jcornell616/Theremax/References/design.jpg

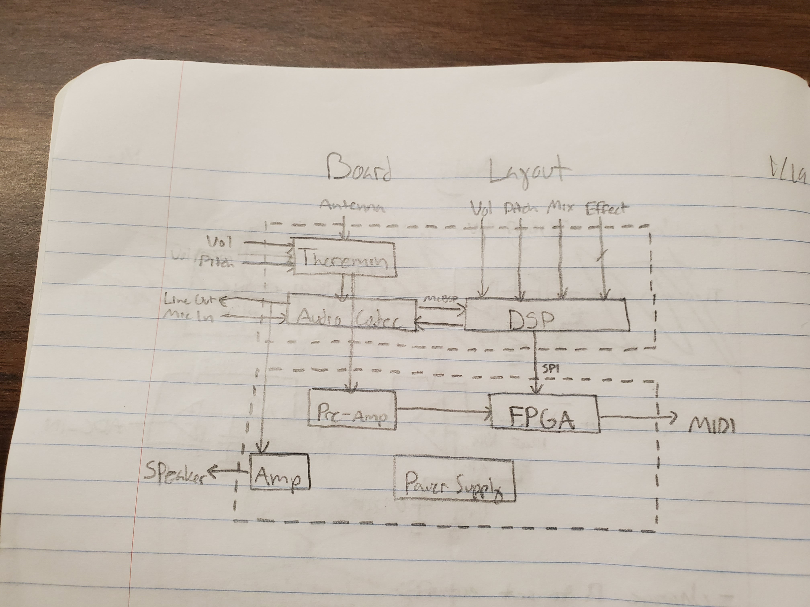
References/design.jpg
