jcornell616/Theremax/Documents/EnclosureDraft.jpg

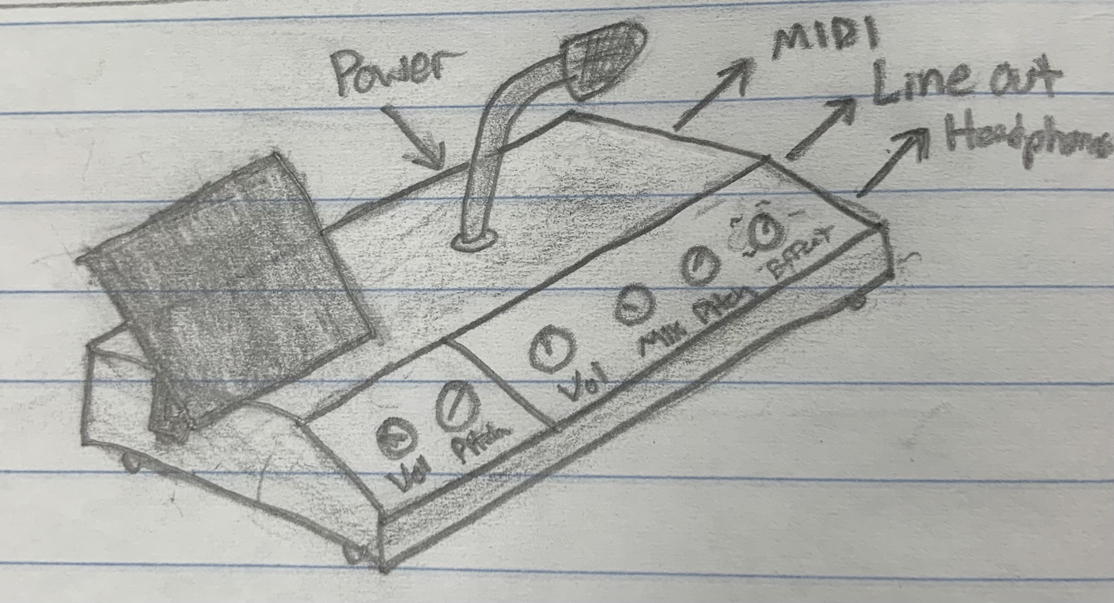
Documents/EnclosureDraft.jpg
