jcornell616/Theremax/Documents/ProgressReports/PR_Cornell_030252022.docx

# Progress Report – 3/25/2022

Jackson Cornell and Eric Barkuloo

- PCBs assembled and debugged
- FPGA pitch detection tweaked
- DSP vocoder code progress continuing

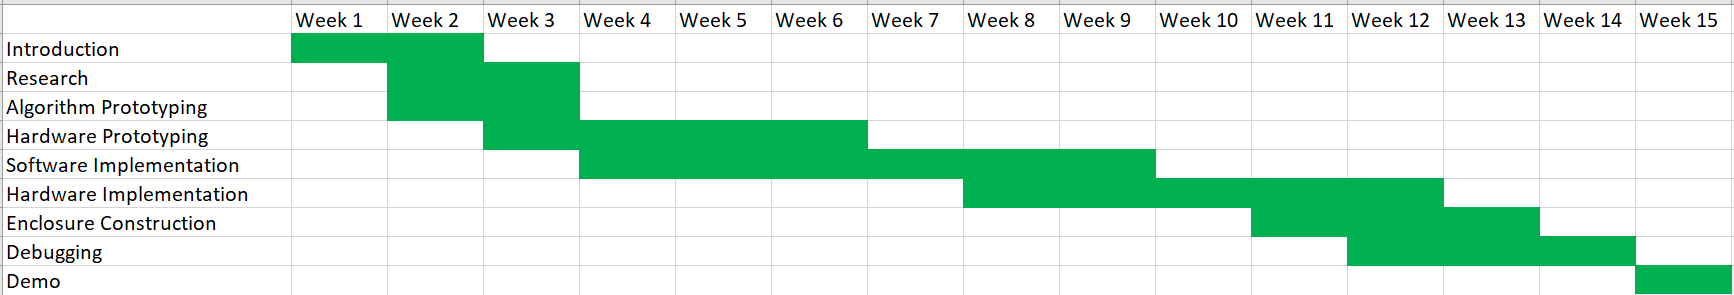
[picture p5: figure]
