jcornell616/Theremax/Documents/ProgressReports/PR_03032022.pdf

# Theremania – PR 3/4/2022

Jackson Cornell – Eric Barkuloo

## Both

- PCB layout finished
- PCBs ordered
- Remaining parts ordered
- Established communication between FPGA and DSP via SPI
