jcornell616/Theremax/Documents/Hardware Block Diagram.jpeg

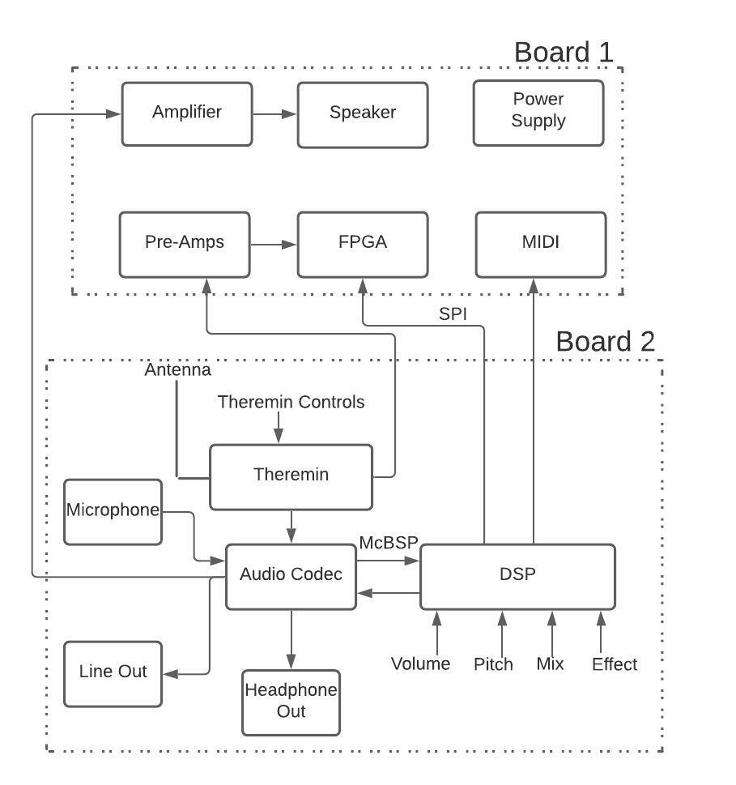
Documents/Hardware Block Diagram.jpeg
