jcornell616/Theremax/Documents/Theremax Software Diagram.jpeg

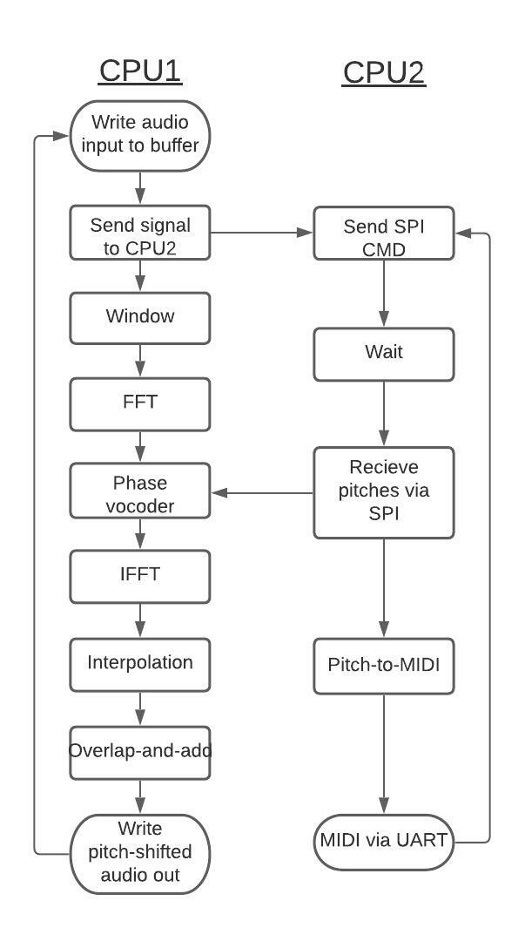
Documents/Theremax Software Diagram.jpeg
