jcornell616/Theremax/References/theramin_schematic4.gif

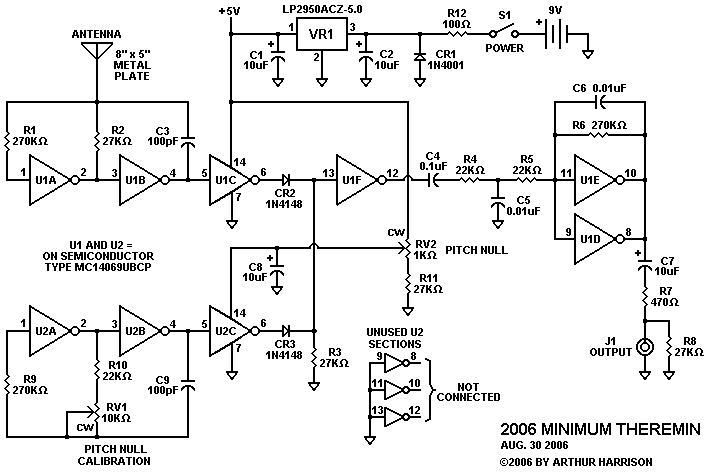
References/theramin_schematic4.gif
