jcornell616/Theremax/Documents/PCB1_Parts.xlsx

Country of Origin may be different at time of shipment.
The HTSUS and ECCN information shown is for informational purposes only and is not a representation or warranty as to the accuracy or reliability of these classifications. All information is provided "as is" and is subject to change without notice. Any use made of the information provided is without recourse to Digi-Key and at the user's risk.
Index | Manufacturer Part Number | Manufacturer Name | Description | Availability | Stock Status | Attrition % | Requested Quantity 1 | Pack Quantity 1 | Pack Type 1 | Digi-Key Part Number 1 | Unit Price 1 | Extended Price 1 | Minimum Order Quantity 1 | Customer Reference | Requested Part Number | Lead Weeks | Datasheet | Reference Designator | US Import Tariff | Note | Part Status | RoHS Status | ECCN | HTSUS | Country of Origin | Environmental Information | Original Part numbers | Image
1 | PAC18R1-41D19F | Bourns Inc. | ENCODER | 165 | In Stock |  | 1 | 1 | Tray | 118-PAC18R1-41D19F-ND | 3.34000 | $3.34 | 1 |  | PAC18R1-41D19F | 24 | //media.digikey.com/pdf/Data%20Sheets/Bourns%20PDFs/PAC18R_Series_DS.pdf |  | May apply on shipments to the U.S. |  | Active | ROHS3 Compliant | EAR99 | 8543.70.4500 | China | https://www.bourns.com/docs/rohs-cofc/coc_en1.pdf?sfvrsn=9f3858d2_12|https://www.bourns.com/docs/rohs-content/bourns-reach-letter.pdf | PAC18R1-41D19F | //media.digikey.com/Photos/Bourns Photos/PAC18R1-41D19F.jpg
2 | PDB181-K420K-103A2 | Bourns Inc. | POT 10K OHM 1/10W CARBON LOG | 162 | In Stock |  | 5 | 5 | Bulk | PDB181-K420K-103A2-ND | 1.24000 | $6.20 | 1 |  | PDB181-K420K-103A2 | 24 | https://www.bourns.com/docs/Product-Datasheets/PDB18.pdf |  | May apply on shipments to the U.S. |  | Active | ROHS3 Compliant | EAR99 | 8533.40.8070 | China | https://www.bourns.com/docs/rohs-content/bourns-reach-letter.pdf |https://www.bourns.com/docs/rohs-cofc/pc1_coc.pdf?sfvrsn=cf7e2294_6 | PDB181-K420K-103A2 | //media.digikey.com/Photos/Bourns%20Photos/PDB181.JPG
3 | P160KN2-0QA25B10K | TT Electronics/BI | POT 10K OHM 1/5W PLASTIC LINEAR | 3,419 | In Stock |  | 5 | 5 | Tray | 987-1715-ND | 0.86000 | $4.30 | 1 |  | P160KN2-0QA25B10K | 25 | https://www.ttelectronics.com/TTElectronics/media/ProductFiles/Datasheets/P160.pdf |  | May apply on shipments to the U.S. |  | Active | ROHS3 Compliant | EAR99 | 8533.40.8070 | China |  | P160KN2-0QA25B10K | //media.digikey.com/Photos/TT%20Electronics%20BI/P160KN2-0QA25B10K.JPG
4 | RMCF0805FT270K | Stackpole Electronics Inc | RES 270K OHM 1% 1/8W 0805 | 40,122 | In Stock |  | 5 | 5 | Cut Tape (CT) | RMCF0805FT270KCT-ND | 0.10000 | $0.50 | 1 |  | RMCF0805FT270K | 22 | https://www.seielect.com/catalog/sei-rmcf_rmcp.pdf |  | May apply on shipments to the U.S. |  | Active | ROHS3 Compliant | EAR99 | 8533.21.0030 | China | https://www.seielect.com/catalog/cert-of-compliance.pdf|https://www.seielect.com/catalog/SEI-RoHS_Compliance_Status.pdf|https://www.seielect.com/catalog/reach.pdf | RMCF0805FT270K | //media.digikey.com/Renders/Stackpole%20Renders/0805.jpg
5 | CRGCQ0805F27K | TE Connectivity Passive Product | RES 27K OHM 1% 1/8W 0805 | 45,271 | In Stock |  | 5 | 5 | Cut Tape (CT) | A129766CT-ND | 0.10000 | $0.50 | 1 |  | CRGCQ0805F27K | 21 | https://www.te.com/commerce/DocumentDelivery/DDEController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 |  | N/A |  | Active | ROHS3 Compliant | EAR99 | 8533.21.0030 | Thailand |  | CRGCQ0805F27K | //media.digikey.com/Renders/TE%20Connectivity/0805-Case-Chip-Resistor.jpg
6 | CRGCQ0805F470R | TE Connectivity Passive Product | RES 470 OHM 1% 1/8W 0805 | 50,654 | In Stock |  | 5 | 5 | Cut Tape (CT) | A129745CT-ND | 0.10000 | $0.50 | 1 |  | CRGCQ0805F470R | 21 | https://www.te.com/commerce/DocumentDelivery/DDEController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 |  | N/A |  | Active | ROHS3 Compliant | EAR99 | 8533.21.0030 | Thailand |  | CRGCQ0805F470R | //media.digikey.com/Renders/TE%20Connectivity/0805-Case-Chip-Resistor.jpg
7 | CRGCQ0805F4K7 | TE Connectivity Passive Product | RES 4.7K OHM 1% 1/8W 0805 | 342,674 | In Stock |  | 10 | 10 | Cut Tape (CT) | A129757CT-ND | 0.05800 | $0.58 | 1 |  | CRGCQ0805F4K7 | 21 | https://www.te.com/commerce/DocumentDelivery/DDEController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 |  | N/A |  | Active | ROHS3 Compliant | EAR99 | 8533.21.0030 | Thailand |  | CRGCQ0805F4K7 | //media.digikey.com/Renders/TE%20Connectivity/0805-Case-Chip-Resistor.jpg
8 | CRGCQ0805F47K | TE Connectivity Passive Product | RES 47K OHM 1% 1/8W 0805 | 86,566 | In Stock |  | 10 | 10 | Cut Tape (CT) | A129769CT-ND | 0.05800 | $0.58 | 1 |  | CRGCQ0805F47K | 21 | https://www.te.com/commerce/DocumentDelivery/DDEController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 |  | N/A |  | Active | ROHS3 Compliant | EAR99 | 8533.21.0030 | Thailand |  | CRGCQ0805F47K | //media.digikey.com/Renders/TE%20Connectivity/0805-Case-Chip-Resistor.jpg
9 | RMCF0805FT100R | Stackpole Electronics Inc | RES 100 OHM 1% 1/8W 0805 | 627,148 | In Stock |  | 10 | 10 | Cut Tape (CT) | RMCF0805FT100RCT-ND | 0.02700 | $0.27 | 1 |  | RMCF0805FT100R | 22 | https://www.seielect.com/catalog/sei-rmcf_rmcp.pdf |  | May apply on shipments to the U.S. |  | Active | ROHS3 Compliant | EAR99 | 8533.21.0030 | Taiwan | https://www.seielect.com/catalog/reach.pdf|https://www.seielect.com/catalog/SEI-RoHS_Compliance_Status.pdf|https://www.seielect.com/catalog/cert-of-compliance.pdf | RMCF0805FT100R | //media.digikey.com/Renders/Stackpole%20Renders/0805.jpg
10 | CRGCQ0805F2K2 | TE Connectivity Passive Product | RES 2.2K OHM 1% 1/8W 0805 | 17,868 | In Stock |  | 2 | 2 | Cut Tape (CT) | A129753CT-ND | 0.10000 | $0.20 | 1 |  | CRGCQ0805F2K2 | 21 | https://www.te.com/commerce/DocumentDelivery/DDEController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 |  | N/A |  | Active | ROHS3 Compliant | EAR99 | 8533.21.0030 | Thailand |  | CRGCQ0805F2K2 | //media.digikey.com/Renders/TE%20Connectivity/0805-Case-Chip-Resistor.jpg
11 | CL21B103KBANNNC | Samsung Electro-Mechanics | CAP CER 10000PF 50V X7R 0805 | 910,520 | In Stock |  | 5 | 5 | Cut Tape (CT) | 1276-1015-1-ND | 0.10000 | $0.50 | 1 |  | CL21B103KBANNNC | 28 | http://www.samsungsem.com/kr/support/product-search/mlcc/CL21B103KBANNNC.jsp |  | N/A |  | Active | ROHS3 Compliant | EAR99 | 8532.24.0020 | China | https://www.samsungsem.com/files/fileDown.do?key=ed1dfdfa-645e-4252-b707-17f9b1502dd1 | CL21B103KBANNNC | //media.digikey.com/Renders/Samsung%20Electro-Mechanics%20America/Ceramic-Capacitor-CL-Series.jpg
12 | CL21A226MQQNNNG | Samsung Electro-Mechanics | CAP CER 22UF 6.3V X5R 0805 | 36,449 | In Stock |  | 5 | 5 | Cut Tape (CT) | 1276-6460-1-ND | 0.14000 | $0.70 | 1 |  | CL21A226MQQNNNG | 28 | //media.digikey.com/pdf/Data%20Sheets/Samsung%20PDFs/CL21A226MQQNNNG_Spec.pdf |  | N/A |  | Active | ROHS3 Compliant | EAR99 | 8532.24.0020 | Philippines | https://www.samsungsem.com/files/fileDown.do?key=ed1dfdfa-645e-4252-b707-17f9b1502dd1 | CL21A226MQQNNNG | //media.digikey.com/Renders/Samsung%20Electro-Mechanics%20America/Ceramic-Capacitor-CL-Series.jpg
13 | CL21A225KAFNNNE | Samsung Electro-Mechanics | CAP CER 2.2UF 25V X5R 0805 | 313,138 | In Stock |  | 5 | 5 | Cut Tape (CT) | 1276-1763-1-ND | 0.13000 | $0.65 | 1 |  | CL21A225KAFNNNE | 28 | http://www.samsungsem.com/kr/support/product-search/mlcc/CL21A225KAFNNNE.jsp |  | N/A |  | Active | ROHS3 Compliant | EAR99 | 8532.24.0020 | China | https://www.samsungsem.com/files/fileDown.do?key=ed1dfdfa-645e-4252-b707-17f9b1502dd1 | CL21A225KAFNNNE | //media.digikey.com/Renders/Samsung%20Electro-Mechanics%20America/Ceramic-Capacitor-CL-Series.jpg
14 | C0805C330G5GAC7800 | KEMET | CAP CER 33PF 50V NP0 0805 | 2,565 | In Stock |  | 1 | 1 | Cut Tape (CT) | 399-14587-1-ND | 0.56000 | $0.56 | 1 |  | C0805C330G5GAC7800 | 53 | https://api.kemet.com/component-edge/download/datasheet/C0805C330G5GACTU.pdf |  | N/A |  | Active | ROHS3 Compliant | EAR99 | 8532.24.0020 | Mexico |  | C0805C330G5GAC7800 | //media.digikey.com/Renders/Kemet%20Renders/0805-(2012-Metric)-2,00x1,20x1,00mm.jpg
15 | C0805C360J5GAC7800 | KEMET | CAP CER 36PF 50V C0G/NP0 0805 | 13,102 | In Stock |  | 1 | 1 | Cut Tape (CT) | 399-C0805C360J5GAC7800CT-ND | 0.29000 | $0.29 | 1 |  | C0805C360J5GAC7800 | 53 | https://api.kemet.com/component-edge/download/datasheet/C0805C360J5GACTU.pdf |  | N/A |  | Active | ROHS3 Compliant | EAR99 | 8532.24.0020 | Mexico |  | C0805C360J5GAC7800 | //media.digikey.com/Renders/Kemet%20Renders/0805-(2012-Metric)-2,00x1,20x1,00mm.jpg
16 | CL21B474KAFNNNG | Samsung Electro-Mechanics | CAP CER 0.47UF 25V X7R 0805 | 872,587 | In Stock |  | 5 | 5 | Cut Tape (CT) | 1276-6480-1-ND | 0.10000 | $0.50 | 1 |  | CL21B474KAFNNNG | 28 | http://www.samsungsem.com/kr/support/product-search/mlcc/CL21B474KAFNNNG.jsp |  | N/A |  | Active | ROHS3 Compliant | EAR99 | 8532.24.0020 | Philippines | https://www.samsungsem.com/files/fileDown.do?key=ed1dfdfa-645e-4252-b707-17f9b1502dd1 | CL21B474KAFNNNG | //media.digikey.com/Renders/Samsung%20Electro-Mechanics%20America/Ceramic-Capacitor-CL-Series.jpg
17 | ECS-122.8-S-4X | ECS Inc. | CRYSTAL 12.2880MHZ SERIES TH | 882 | In Stock |  | 1 | 1 | Bulk | X1101-ND | 0.70000 | $0.70 | 1 |  | ECS-122.8-S-4X | 19 | https://ecsxtal.com/store/pdf/hc-49usx.pdf |  | May apply on shipments to the U.S. |  | Active | ROHS3 Compliant | EAR99 | 8541.60.0050 | Taiwan |  | ECS-122.8-S-4X | //media.digikey.com/photos/ECS%20Photos/ECS-200-20-4X.JPG
18 | 1N4148WTR | SMC Diode Solutions | DIODE GEN PURP 75V 250MA SOD123 | 717,720 | In Stock |  | 4 | 4 | Cut Tape (CT) | 1655-1360-1-ND | 0.14000 | $0.56 | 1 |  | 1N4148WTR | 14 | http://www.smc-diodes.com/propdf/1N4148W%20N0571%20REV.E.pdf |  | May apply on shipments to the U.S. |  | Active | ROHS3 Compliant | EAR99 | 8541.10.0070 | - | http://www.smc-diodes.com/uploadfile/Declaration%20Letter%20for%20EU%20REACH-3.pdf|http://www.smc-diodes.com/uploadfile/ROHS%20Declaration%20Letter-3.pdf | 1N4148WTR | //media.digikey.com/Renders/SMC%20Diode%20Solutions/1655;SOD123;;2.jpg
19 | CMC-97452-L100 | CUI Devices | MIC COND ANLG UNI -37DB 9.7MM D | 96 | In Stock |  | 1 | 1 | Box | 102-5637-ND | 3.51000 | $3.51 | 1 |  | CMC-97452-L100 | 14 | https://www.cuidevices.com/product/resource/cmc-97452-l100.pdf |  | N/A |  | Active | ROHS3 Compliant | EAR99 | 8518.10.8030 | China | https://www.cuidevices.com/product/resource/material-compliance/cmc-97452-l100 | CMC-97452-L100 | //media.digikey.com/Photos/CUI%20Photos/MFG_CMC-97452-L100.jpg
