jcornell616/Theremax/(list of files, cad)

Other CAD files:
Hardware/Enclosure/Enclosure_Revision.SLDPRT
Hardware/Enclosure/Enclosure.SLDPRT
