jcornell616/Theremax/Hardware/PCB2/connectors.pdf

# Connections

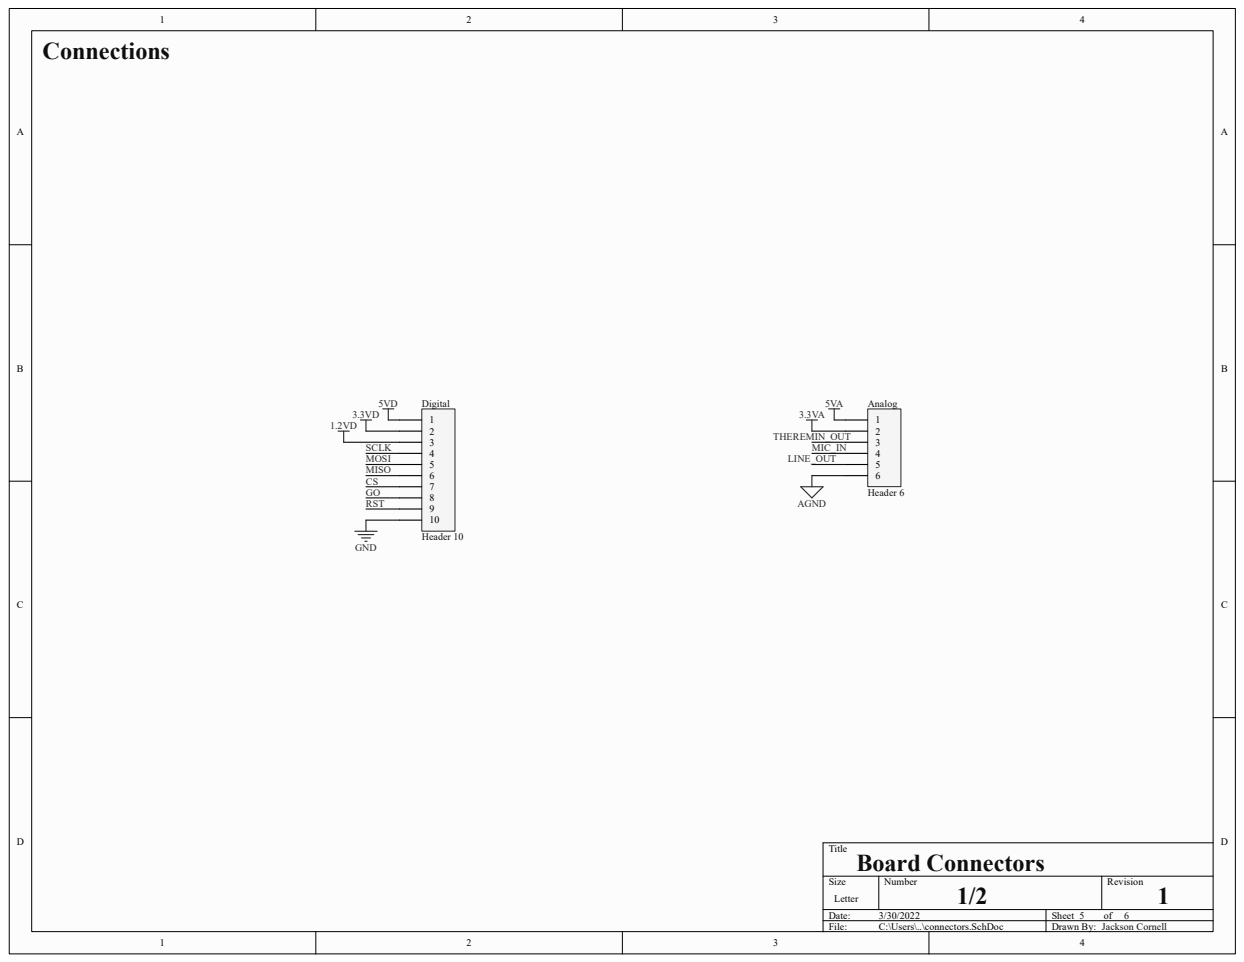
[picture p11: page 1]
Title; Size; Number; Revision; Letter; Date:; Sheet; File:; C:\Users\..\connectors.SchDoc; Drawn By:; SCLK MOSI MISO CS; GND; THEREMIN_OUT MIC_IN LINE_OUT; AGND; Board Connectors; Jackson Cornell; GO RST; Digital; Header 10; Analog; Header 6
