jcornell616/Theremax/Hardware/PCB2/fpga.pdf

# Connections

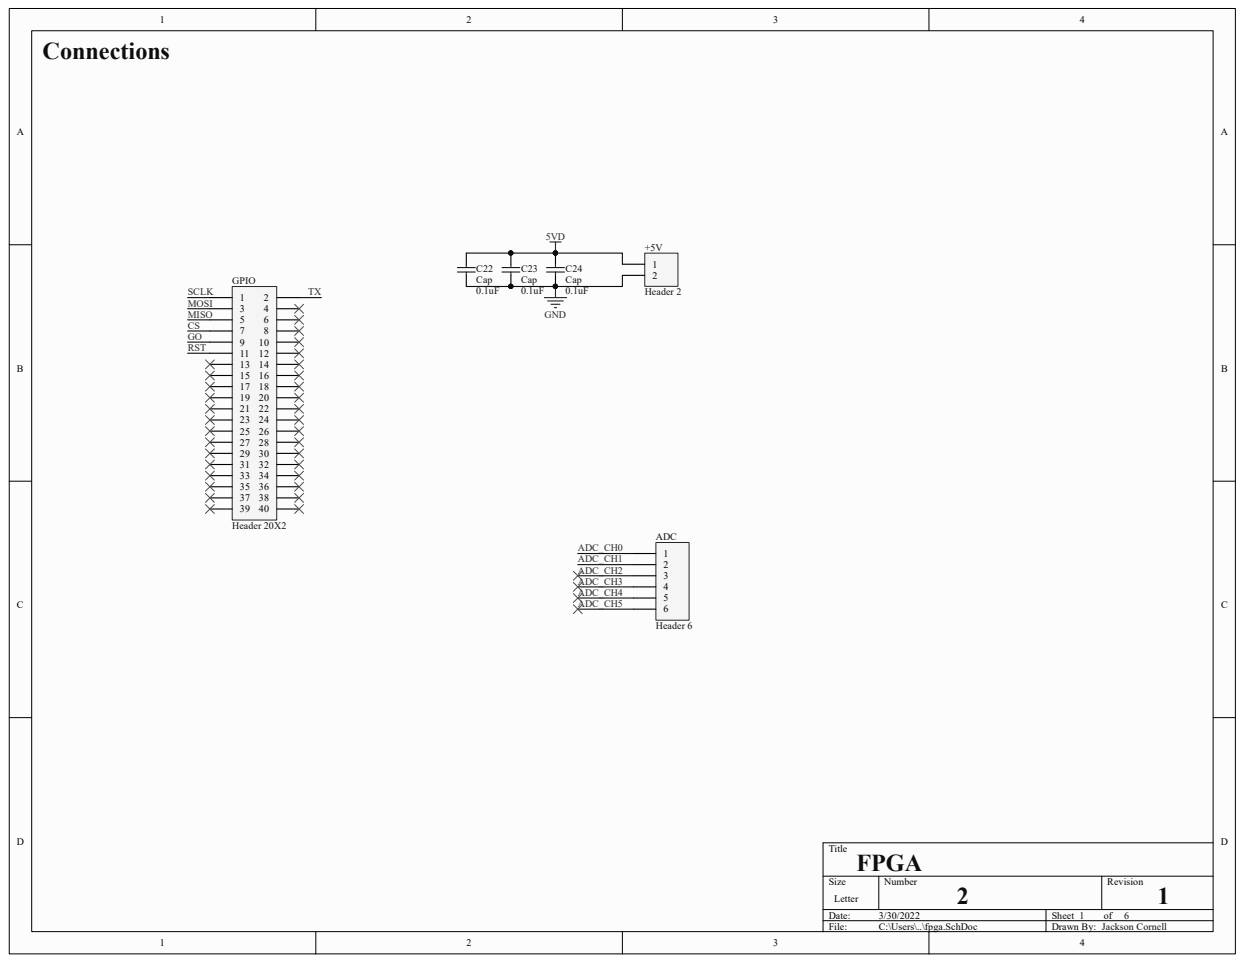
[picture p12: page 1]
Title; Size; Number; Revision; Letter; Date:; Sheet; File:; C:\Users\..\fpga.SchDoc; Drawn By:; GPIO; Header 20X2; ADC; Header 6; ADC_CH0 ADC_CH1 ADC_CH2 ADC_CH3 ADC_CH4 ADC_CH5; Header 2; C24 Cap; C23 Cap; C22 Cap; GND; FPGA; Jackson Cornell; SCLK MOSI MISO CS GO RST
