jcornell616/Theremax/Hardware/PCB2/midi.pdf

# MIDI Out

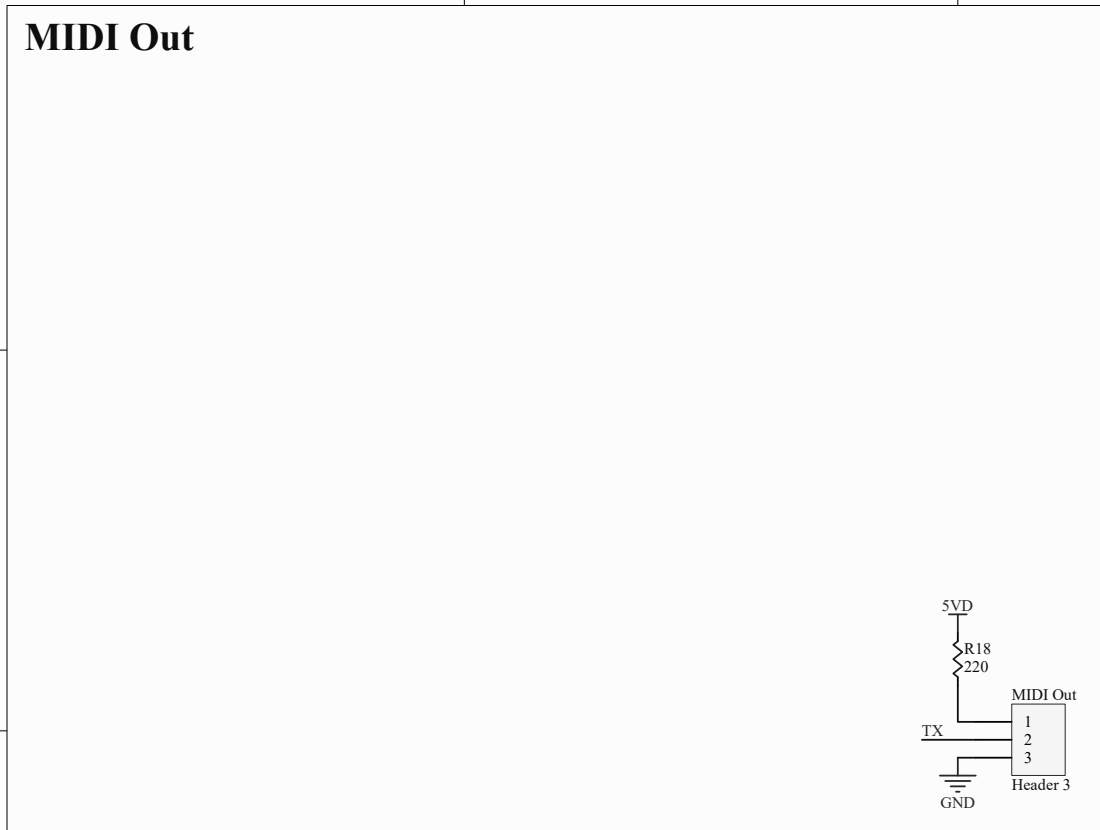
[picture p13: page 1]
Title; Size; Number; Revision; Letter; Date:; Sheet; File:; C:\Users\..\midi.SchDoc; Drawn By:; MIDI; Jackson Cornell; MIDI Out; Header 3; GND
