jcornell616/Theremax/Hardware/PCB2/power.pdf

# Power Filtering

# Connectors

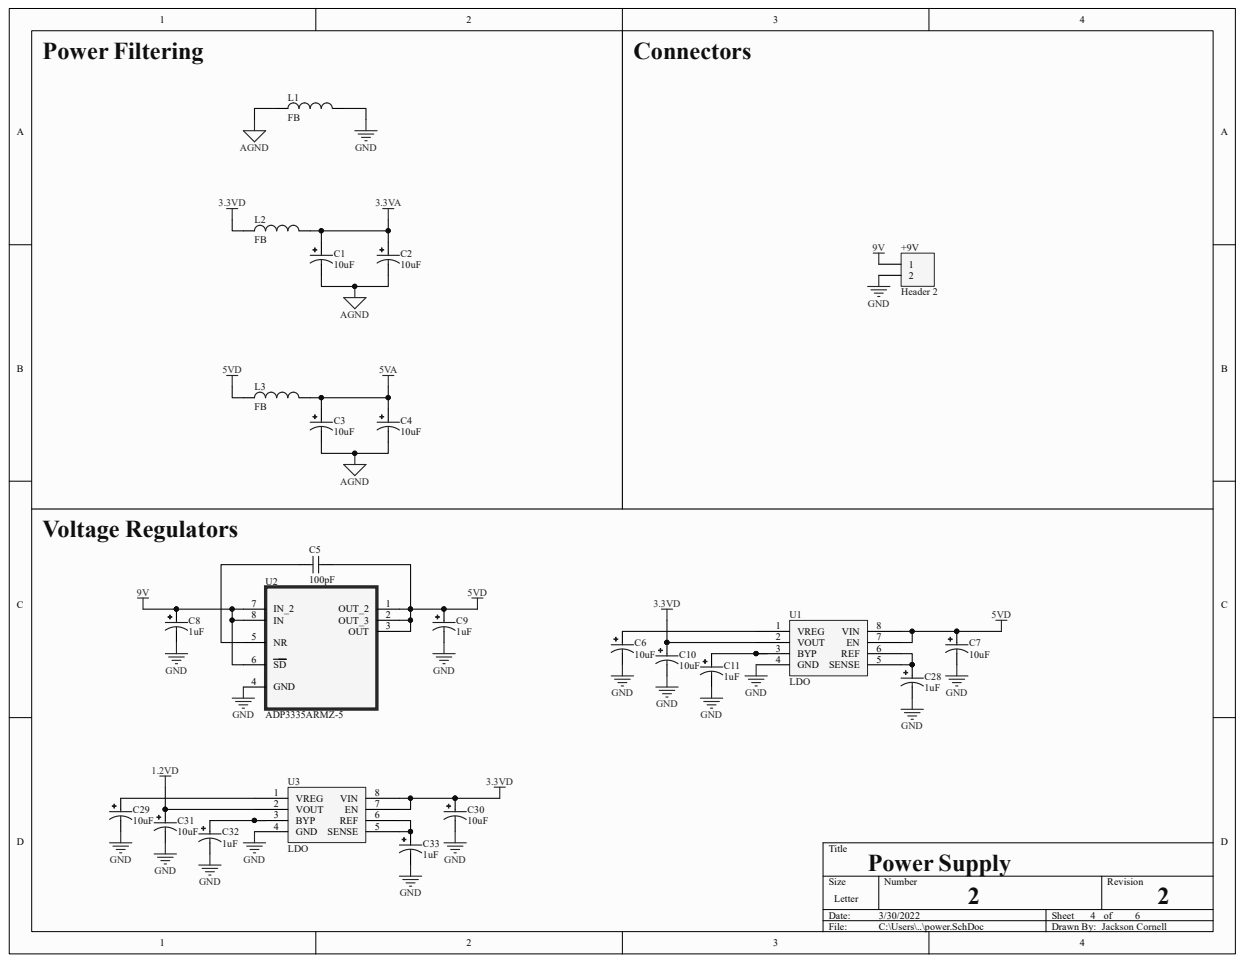
[picture p14: page 1]
