jcornell616/Theremax/Hardware/PCB2/preamp.pdf

Pre-Amps | Power Filtering

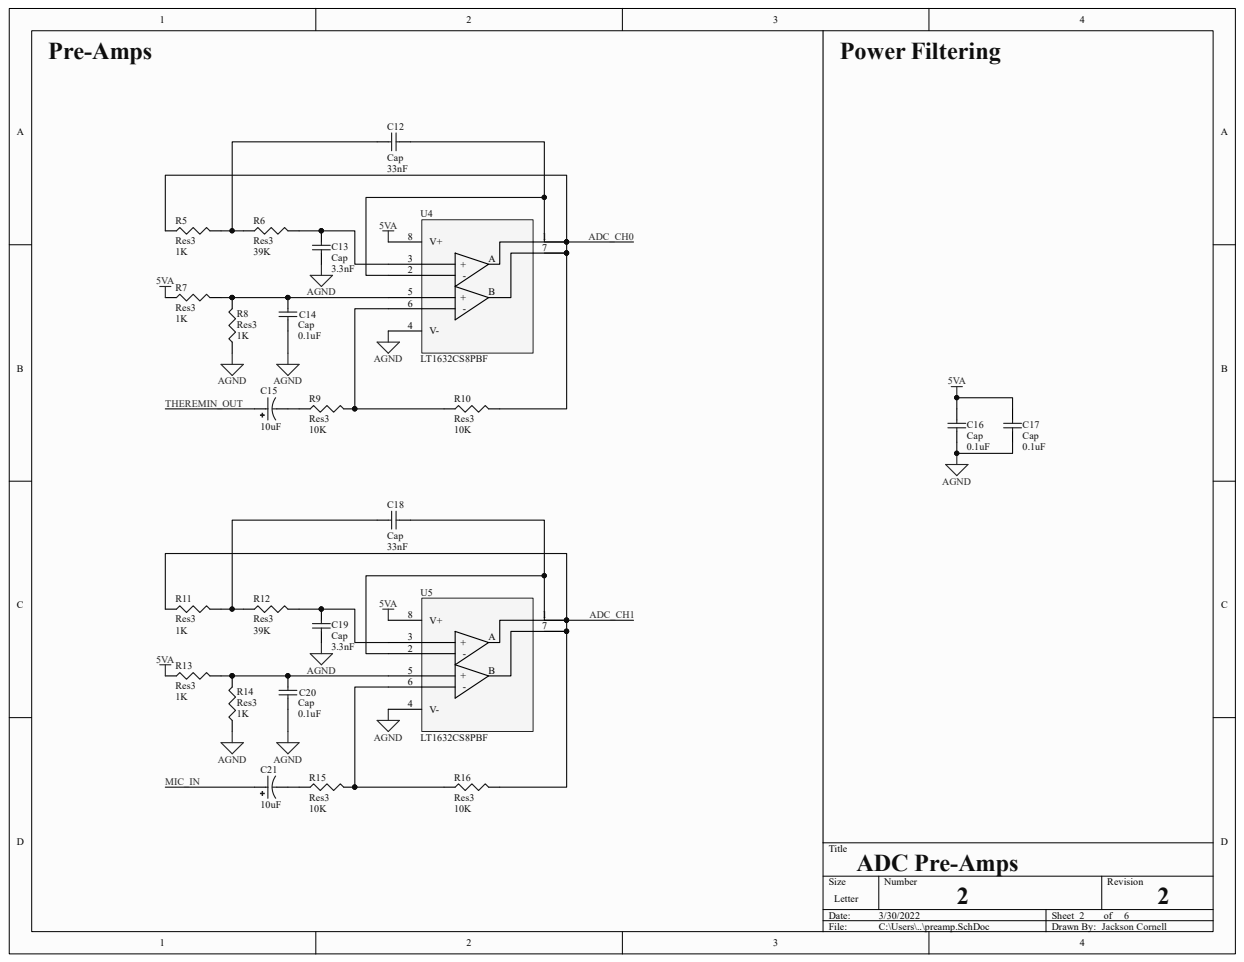
[picture p15: page 1]
