jcornell616/Theremax/Hardware/PCB2/speaker.pdf

# Speaker and Power Amplifier

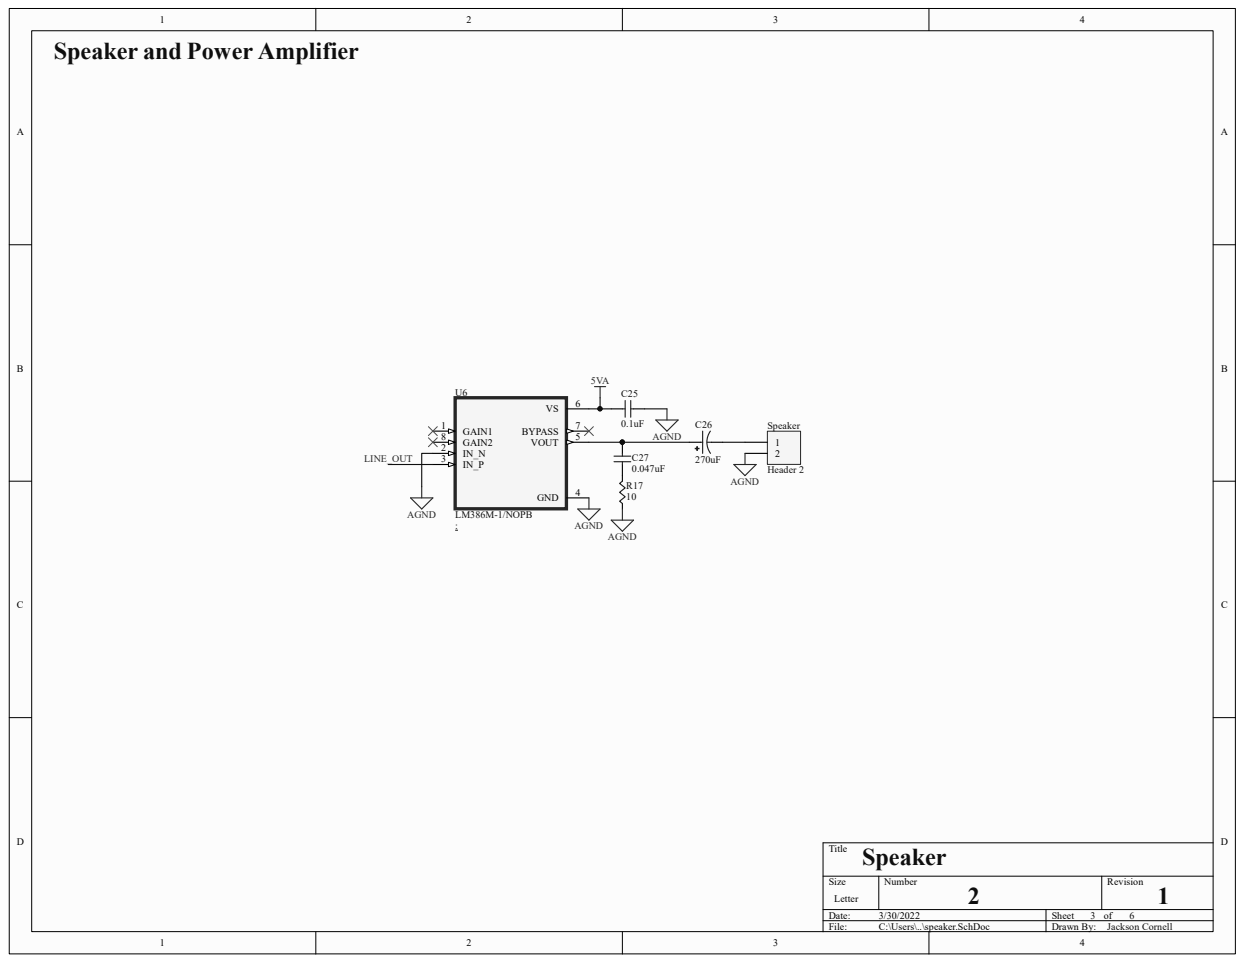
[picture p16: page 1]
Title; Size; Number; Revision; Letter; Date:; Sheet; File:; C:\Users\..\speaker.SchDoc; Drawn By:; Speaker; Header 2; GAIN1 1 GAIN2 8 IN_N 2 IN_P 3; BYPASS; VOUT; GND; LM386M-1/NOPB; AGND; LINE_OUT; 3 6 Jackson Cornell
