jcornell616/Theremax/(list of files, drawings)

Other design files:
Hardware/PCB1/codec.SchDoc
Hardware/PCB1/connectors.SchDoc
Hardware/PCB1/DSP1.SchDoc
Hardware/PCB1/DSP2.SchDoc
Hardware/PCB1/PCB1.PcbDoc
Hardware/PCB1/theremin.SchDoc
Hardware/PCB2/connectors.SchDoc
Hardware/PCB2/fpga.SchDoc
Hardware/PCB2/midi.SchDoc
Hardware/PCB2/power.SchDoc
Hardware/PCB2/preamp.SchDoc
Hardware/PCB2/speaker.SchDoc
Hardware/PCB2/theremania_test_board2.PcbDoc
