jcornell616/Theremax/(commit log)

2022-01-13 improved pitch detection
2022-01-13 codec schematic
2022-01-17 enclosure draft
2022-01-19 board1 schematics and parts list
    [codec.SchDoc, power.SchDoc, theremin.SchDoc]
2022-01-21 uploaded DE10 manual and c2000 schematic
2022-01-25 updated schematics
    [codec.SchDoc, connectors.SchDoc, fpga.SchDoc, power.SchDoc, preamp.SchDoc, theremin.SchDoc]
2022-01-26 diagrams and power schematic
    [power.SchDoc]
2022-01-31 Fixed small error on codec and added DSP (still missing ADC connections+power)
    [DSP.SchDoc]
2022-01-31 Adding DSP schematic (incomplete), fixed small error w/ codec
    [codec.SchDoc]
2022-02-05 Adding DSP schematic
    [DSP.SchDoc]
2022-02-09 Updating DSP
    [DSP.SchDoc, DSP1.SchDoc, DSP2.SchDoc, connectors.SchDoc]
2022-02-09 Finished DSP designs, fixed a few aesthetic things on some of the other schematics
    [DSP1.SchDoc, DSP2.SchDoc, codec.SchDoc, connectors.SchDoc, fpga.SchDoc, power.SchDoc, preamp.SchDoc, theremin.SchDoc]
2022-02-09 Updating DSP+codec
    [DSP1.SchDoc, DSP2.SchDoc, codec.SchDoc]
2022-02-09 fixed power
    [power.SchDoc]
2022-02-11 speaker schematic
    [speaker.SchDoc]
2022-02-14 Adding codec library w/ TSSOP footprint
2022-02-14 Updated schematic w/ correct footprints
    [DSP1.SchDoc, DSP2.SchDoc, codec.SchDoc, connectors.SchDoc, theremin.SchDoc]
2022-02-19 updated schematics and PCB
    [connectors.SchDoc, fpga.SchDoc, midi.SchDoc, power.SchDoc, preamp.SchDoc, speaker.SchDoc, theremania_test_board2.PcbDoc]
2022-02-25 BOM an altium design rule check
    [Theremania.xlsx]
2022-02-25 Adding PCB1
    [DSP1.SchDoc, DSP2.SchDoc, PCB1.PcbDoc, codec.SchDoc, connectors.SchDoc, theremin.SchDoc]
2022-02-25 board 2 output files
2022-02-28 Adding PCB1 BOM
    [PCB1_Parts.xlsx]
2022-02-28 Finish BOM
    [PCB1_Parts.xlsx]
2022-03-25 a couple of changes
    [Theremania.xlsx]
2022-03-29 board iter 2
2022-03-30 mic & adc drivers
2022-04-04 enclosure CAD file
    [Enclosure.SLDPRT]
2022-04-08 dsp lab
    [Enclosure_Revision.SLDPRT]
2022-04-18 encoder code
2022-04-18 edited encoder
2022-04-18 device file
2022-04-20 lcd drivers
